LakeMaps/Dartmouth/README.md

# PCB
This is where the PCBs go, because "boat" was taken
