LakeMaps/Dartmouth/Settle/settle.kicad_pcb

## KiCad design Settle/settle.kicad_pcb (2016-10-25)

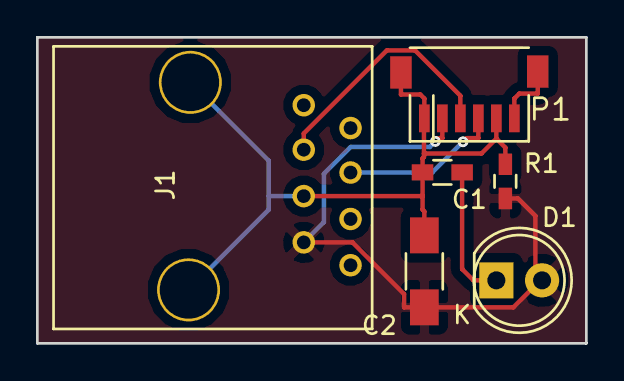
[picture p1: board settle.kicad_pcb from above]

Board: 2 copper layers, 30.5 x 17.0 mm, 6 parts (0 on the bottom side), 5 nets.

Parts:
C1: 0.1u; C_0603_HandSoldering
C2: 10u; C_1206_HandSoldering
D1: LED; LED-5MM
J1: RJ45; RJ45_Header
P1: CONN_01X06; JST-6
R1: 150; R_0603_HandSoldering

Connections:
+5V: C1.1, C2.1, D1.2, J1.2, P1.2
/Rx: J1.6, P1.3
/Tx: J1.5, P1.4
Earth: C1.2, C2.2, J1.4, J1.9, P1.1, P1.5, R1.2
unnamed: D1.1, R1.1
