LakeMaps/Dartmouth/Cranberry/cranberry.kicad_pcb

## KiCad design Cranberry/cranberry.kicad_pcb (2016-10-25)

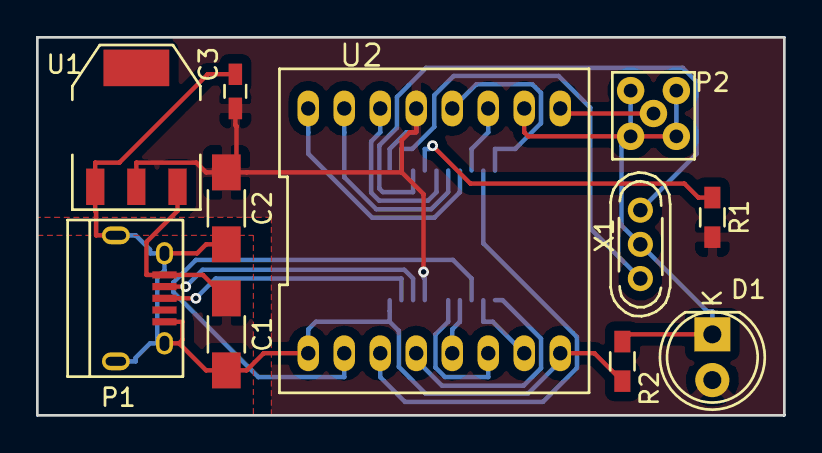
[picture p2: board cranberry.kicad_pcb from above]

Board: 2 copper layers, 41.5 x 21.0 mm, 12 parts (1 on the bottom side), 21 nets.

Parts:
C1, C2: 4.7u; C_1206_HandSoldering
C3: 10n; C_0603_HandSoldering
D1: LED; LED-5MM
P1: USB_OTG; USB_Micro-B
P2: SMA; RP-SMA
R1: 390; R_0603_HandSoldering
R2: 33; R_0603_HandSoldering
U1: NCP1117ST33T3G; SOT-223
U2: RFM69HCW; RFM_Module
U3: MCP2210; SSOP-20_5.3x7.2mm_Pitch0.65mm
X1: 12MHz; Crystal_HC52-U_Vertical_3Pin

Connections:
+3V3: C2.1, C3.1, D1.2, R1.1, U1.2, U2.13, U3.1, U3.17
+5V: C1.1, P1.1, U1.3
/IO0: U2.14, U3.5
/IO1: U2.15, U3.6
/IO2: U2.16, U3.7
/IO3: U2.11, U3.8
/IO4: U2.12, U3.10
/IO5: U2.7, U3.12
/MISO: U2.2, U3.13
/MOSI: U2.3, U3.9
/RFM_RST: U2.6, U3.15
/SCK: U2.4, U3.11
/SS_0: U2.5, U3.14
/USB_D+: P1.3, U3.19
/USB_D-: P1.2, U3.18
Earth: C1.2, C2.2, C3.2, P1.5, P1.6, P2.2, R2.2, U1.1, U2.1, U2.8, U2.10, U3.20, X1.3
unnamed: D1.1, R2.1
unnamed: P2.1, U2.9
unnamed: R1.2, U3.4
unnamed: U3.2, X1.1
unnamed: U3.3, X1.2
