LakeMaps/Dartmouth/Loon/loon.kicad_pcb

## KiCad design Loon/loon.kicad_pcb (2016-10-25)

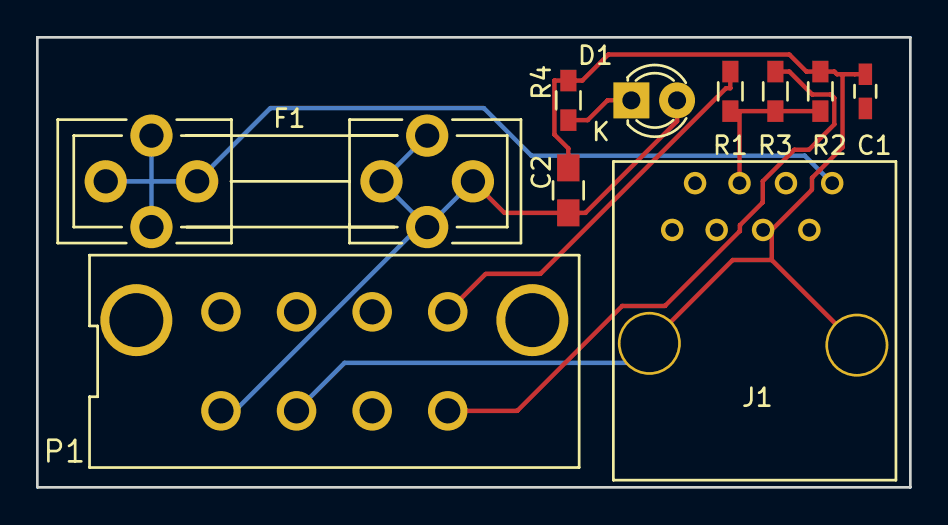
[picture p3: board loon.kicad_pcb from above]

Board: 2 copper layers, 48.5 x 25.0 mm, 10 parts (0 on the bottom side), 7 nets.

Parts:
C1: 0.1u; C_0603_HandSoldering
C2: 10u; C_0805_HandSoldering
D1: LED; LED-3MM
F1: FUSE; Fuseholder5x20_horiz_open_universal_Type-III
J1: RJ45; RJ45_Header
P1: CONN_01X07; 8_Pin_Minifit
R1, R2, R3: R; R_0603_HandSoldering
R4: 1k; R_0603_HandSoldering

Connections:
+12V: F1.2, J1.1
/12_fuse: C2.1, D1.2, F1.1, P1.1
/Tx: J1.5, R1.1, R2.2, R3.1
Earth: C1.2, C2.2, J1.4, J1.9, P1.2, R3.2, R4.2
unnamed: D1.1, R4.1
unnamed: P1.4, R2.1
unnamed: P1.5, R1.2
