LakeMaps/Dartmouth/Dartmouth/dartmouth.kicad_pcb

## KiCad design Dartmouth/dartmouth.kicad_pcb (2016-10-25)

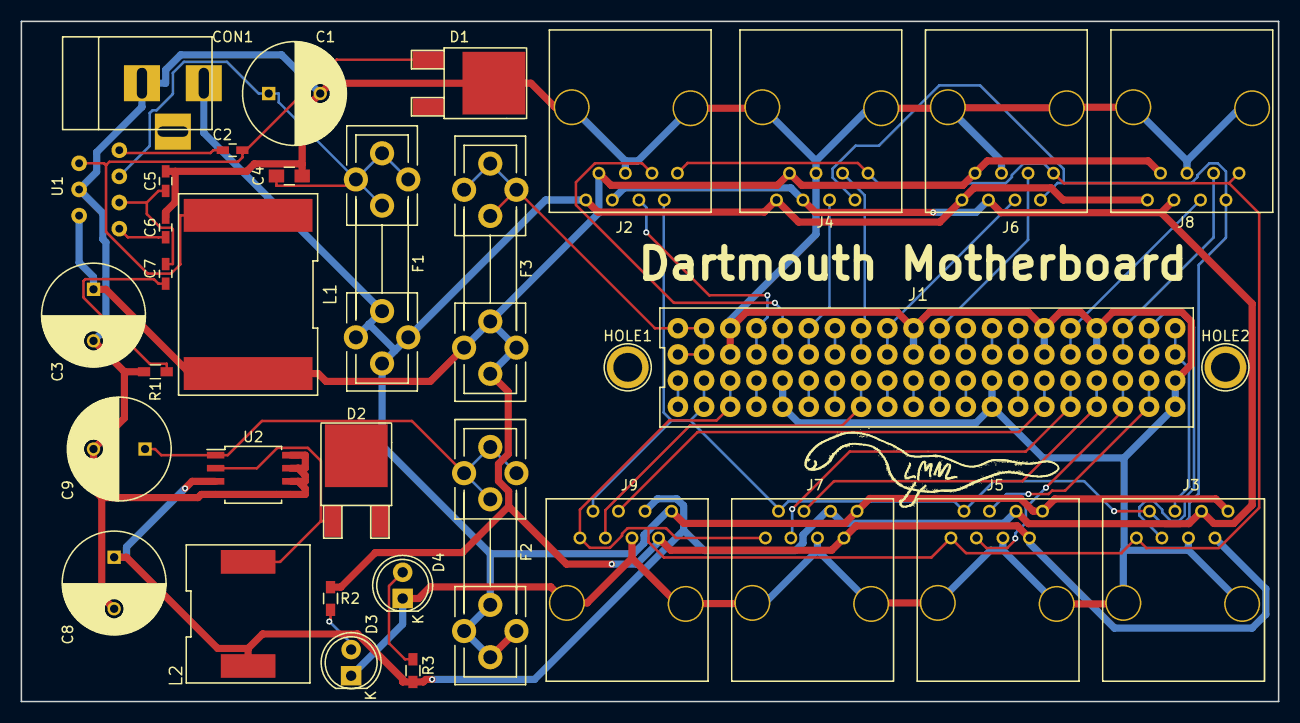
[picture p4: board dartmouth.kicad_pcb from above]

Board: 2 copper layers, 122.0 x 66.0 mm, 36 parts (0 on the bottom side), 33 nets.

Parts:
C1: 2200uF; C_Radial_D10_L13_P5
C2, C6: 0.22uF; C_0603_HandSoldering
C3: 470uF; C_Radial_D10_L13_P5
C4: 4.7uF; C_0805_HandSoldering
C5: 680pF; C_0603_HandSoldering
C7: 1200pF; C_0603_HandSoldering
C8, C9: 470u; C_Radial_D10_L13_P5
CON1: BARREL_JACK
D1, D2: STPS1045B-TR; TO-252-2Lead
D3, D4: LED; LED-5MM
F1, F2, F3: FUSE; Fuseholder5x20_horiz_open_universal_Type-III
HOLE1, HOLE2: 1pin
J1: RPi_GPIO; Raspi_Header
J2, J3, J4, J5, J6, J7, J8, J9: RJ45; RJ45_Header
L1: 56uH; SRP_Series_Ind
L2: 47uH; SRR1210A_Series_Ind
LOGO: GrandyHype_25mm
R1: 39k; R_0603_HandSoldering
R2: 220; R_0603_HandSoldering
R3: 33; R_0603_HandSoldering
U1: SI-8050Y; TO-220-7
U2: AP1509; SOIJ-8_5.3x5.3mm_Pitch1.27mm

Connections:
+3V3: C8.1, J2.3, J3.3, J4.3, J5.3, J6.3, J7.3, J8.3, J9.3, L2.1, R3.1, U2.3
+5V: C3.1, F3.1, J2.2, J3.2, J4.2, J5.2, J6.2, J7.2, J8.2, J9.2, L1.2, R2.1, U1.6
+12V: CON1.1, F1.1, F2.1, J2.1, J3.1, J4.1, J5.1, J6.1, J7.1, J8.1, J9.1
/5VPi: F3.2, J1.2, J1.4
/12-3v3Fused: C9.1, F2.2, U2.1
/12-5Fuse: C1.1, C4.1, F1.2, U1.3
/GPIO05: J1.29, J9.5
/GPIO06: J1.31, J7.6
/GPIO12: J1.32, J8.5
/GPIO13: J1.33, J7.5
/GPIO14: J1.8, J2.5
/GPIO15: J1.10, J2.6
/GPIO16: J1.36, J8.6
/GPIO18: J1.12, J4.5
/GPIO19: J1.35, J5.6
/GPIO20: J1.38, J3.6
/GPIO21: J1.40, J3.5
/GPIO22: J1.15, J9.6
/GPIO23: J1.16, J4.6
/GPIO24: J1.18, J6.5
/GPIO25: J1.22, J6.6
/GPIO26: J1.37, J5.5
/SCL: J1.5, J2.8, J3.8, J4.8, J5.8, J6.8, J7.8, J8.8, J9.8
/SDA: J1.3, J2.7, J3.7, J4.7, J5.7, J6.7, J7.7, J8.7, J9.7
Earth: C1.2, C3.2, C4.2, C5.2, C6.2, C8.2, C9.2, CON1.2, D1.2, D3.1, D4.1, J1.6, J1.9, J1.20, J1.25, J1.30, J1.34, J1.39, J2.4, J2.9, J3.4, J3.9, J4.4, J4.9, J5.4, J5.9, J6.4, J6.9, J7.4, J7.9, J8.4, J8.9, J9.4, J9.9, R1.2, U1.4, U2.4, U2.5, U2.6, U2.7, U2.8
unnamed: C2.1, U1.1
unnamed: C2.2, D1.1, L1.1, U1.2
unnamed: C5.1, C7.1, U1.5
unnamed: C6.1, U1.7
unnamed: C7.2, R1.1
unnamed: D2.1, L2.2, U2.2
unnamed: D3.2, R2.2
unnamed: D4.2, R3.2
