LakeMaps/Dartmouth/(threads)

Thread 1 (2016-07-27):

Motherboard Design

FifoIronton, 2016-07-27:
We need to map out what we want on this board.
This board is pretty much a header for the Raspberry Pi.
Needs:
- Power rails,
- 12V to 3V, 12V to 5V buck convertors
- Standard mother to daughter 8 pin JST terminals ( 2 GPIO, 3.3V, 5V, GND, SDA&SCL, something else)
- USB Bus?
- Logo

We should use this issue to develop a discussion of the components.

arandell93, 2016-07-27:
I don't think we need a USB bus. We can't get a USB bus off of the headers on the Pi anyway.

We need to have no connects to all of the Pi's voltage outputs, since we're going to be bringing in our own power from our DC/DC converters to all the devices. However, all of the grounds will be common (unless there is a reason not to, but I can't imagine having a noisy ground in this system).

For the pins that aren't scheduled to be used for daughterboard connections, we should break them out onto similar connectors anyway in case we want to use them. For example, the SPI bus on the Pi could be brought out to an 8pin JST with 5V, 3.3V, GND and a couple no connects.

arandell93, 2016-07-27:
Not sure if JST is the best to use, I think putting the pins in is difficult.
What are your thoughts on using something like CAT5/RJ45? They're easy to use, the crimp tools are cheap and I have 185 feet of cable already.
I know it's kinda gross because we'd be using a standardized port for something non-standard, but there are a good few pros.
Thoughts?

FifoIronton, 2016-07-27:
I'll be honest, I just kind of assumed that this connector was JST : http://www.digikey.com/product-search/en?mpart=71600-108LF&vendor=609 . These interface with 10mil pin headers, which are nice.

Turns out I was wrong. If you have CAT5 cable and the skills to terminate, although it hurts me I can do it, because cheap solutions sound like a good idea

arandell93, 2016-07-27:
I haven't seen those before haha. JST is super small.
It hurts me too but I think it's a good decision in terms of ease of manufacture and costs. RJ45 it is!

arandell93, 2016-08-11:
Preliminary _in progress_ design
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

arandell93, 2016-08-11:
Markup as submitted to @FifoIronton on 2016-08-10 22:45
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

Closed 2016-11-06.

Thread 2 (2016-07-27):

'Cranberry' Radio Module Daughterboard

FifoIronton, 2016-07-27:
Need to create a radio module breakout board for RFM9XW. We want:
- RPSMA output
- SPI to microUSB port
- 3.3V linear regulator

arandell93, 2016-07-27:
Since we need two modules (one on the boat and one on shore), I think we're best making them identical.

Note: We are going to be bringing ONLY a USB cable to these modules. Power will be in the form of 5V via USB, so a USB hub is required to provide enough current.

Any SPI to USB converter chip we get will have to be capable of at least 300 kbit/s

arandell93, 2016-07-27:
I'm gonna go ahead and make this priority ahead of the motherboard, as I feel this will take the most work to get sorted (config, testing, antenna messing), and it is independent of the motherboard so the latter work can be parallel to the development of the other boards.

arandell93, 2016-07-27:
Potential SPI to USB converter:
https://www.digikey.ca/product-detail/en/microchip-technology/MCP2210-I-SS/MCP2210-I-SS-ND/2835087
Also available in SMD, but I think this package would be easier to solder to.

FifoIronton, 2016-07-27:
We wouldn't be able to use the alternate package that they have, as the pads are underneath the chip on that package.

Speaking of that, we should probably aim to get several of the boards done so I can solder and verify them at Solace - the pins on the chip you've shared are only separated by about a millimeter, and Solace much smaller soldering irons than I have access to at MUN.
I'm not sure if Solace'll let me borrow a key for after hours access during the semester, but I will ask about it closer to the end of my work term.

arandell93, 2016-07-27:
Yeah that's what I'm thinking. I'll create a tracking issue for that.

FifoIronton, 2016-08-01:
First draft of schematic fleshed out as of 87f1c00

If you think this looks appropriate I will continue working towards finishing layout ASAP
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

arandell93, 2016-08-01:
Are we using any of the IO on the radio module? I see you've got them all connected to the USB-SPI bridge GPIO, but do we know how to get at the GPIO in software via the USB interface?

FifoIronton, 2016-08-01:
I'll be honest, I haven't actually read the full data sheets for both of them. I'm like 80% sure that the GPIO are controlled by the USB interface, as they'd be needed as for Slave Select (SS) pins for the SPI interface (assuming you're not doing some complex Daisy Chaining thing).
Based on the LoRa balloon system I've shown you before, the guy connects some of the IOs on that module for selecting options or something in his [software](https://github.com/daveake/LoRaArduinoSerial/blob/master/LoRaArduinoSerial.ino). It's another thing I haven't actually read, but I want to figure out what's going on there

FifoIronton, 2016-08-07:
Next time let's get the SOIC footprint instead of the SSOP footprint. Wider lead spacing, which is good for me

FifoIronton, 2016-08-17:
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
Things to be done:
- Change hole sizes
- Put a fun label on?
- make sure it doesn't suck

arandell93, 2016-08-17:
- Am I correct in understanding that the MCP2210 is underneath the RFM69HCW where the MCP is surface mount on one side and the RFM is through-hole mounted on the other?
 - Side note: We will need pins (what spacing) to mount the RFM through-hole.
- Power LED resistor should be 33 Ohms.

FifoIronton, 2016-10-25:
Rev1 Schematic of this board
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

Closed 2016-11-06.

Thread 3 (2016-07-27):

Choose kooky naming scheme for boards

FifoIronton, 2016-07-27:
When I worked at a big company, families of boards that they designed all had internal names based on a   set theme. For example, in one family, all cards were named after stars, and in another family all of the cards were named after characters from a movie.

I think we should emulate this on our project, mostly so that everything sounds a little sillier when we talk about it. Also, I'm jealous that the control software repository gets to be called "boat", while I have a repository called "PCB" currently.

Some options for a board naming theme:
- YuGiOh Cards in a 2011 era Frog deck, or maybe an Elemental Hero Absolute Zero Deck
- Names of lakes geographically close to my family home in Dartmouth
- Different names of blue Crayola crayons, with the motherboard being named "Blue"
- My favourite flavours of herbal tea

What do you guys think?

arandell93, 2016-07-27:
I like the names of ponds & puddles close to your family home in Dartmouth.
We can call the motherboard Dartmouth then?

I also like the blue crayola crayon idea.

FifoIronton, 2016-07-27:
Dartmouth it is then, I'll implement the changes when I get back home

arandell93, 2016-07-27:
Close the issue once you've implemented the naming scheme.

Closed 2016-07-27.

Thread 4 (2016-07-27):

Tracking: PCB Board Design & Fabrication

arandell93, 2016-07-27:
These are listed in order of priority.
Each board should have a separate issue created for it to discuss relevant things, but progress will be tracked here and dates will be assigned.
### Radio Module Board (#2)
- [ ] Circuit Design & Schematic [August 3]
- [ ] Component Selection [July 28]
- [ ] PCB Layout [August 3]
- [ ] PCB Ordering [August 5]
- [ ] PCB Assembly
- [ ] Testing
### Motherboard (Dartmouth) (#1)
- [ ] Circuit Design & Schematic [August 3]
- [ ] Component Selection [August 3]
- [ ] PCB Layout
- [ ] PCB Ordering
- [ ] PCB Assembly
- [ ] Testing
### GPS Daughterboard
- [ ] Circuit Design & Schematic
- [ ] Component Selection
- [ ] PCB Layout
- [ ] PCB Ordering
- [ ] PCB Assembly
- [ ] Testing
### Sonar Daughterboard
- [ ] Circuit Design & Schematic
- [ ] Component Selection
- [ ] PCB Layout
- [ ] PCB Ordering
- [ ] PCB Assembly
- [ ] Testing
### Motor Controller Daughterboard
- [ ] Circuit Design & Schematic
- [ ] Component Selection
- [ ] PCB Layout
- [ ] PCB Ordering
- [ ] PCB Assembly
- [ ] Testing

Closed 2016-11-06.

Thread 5 (2016-08-03):

Dartmouth Daughterboard Interface

arandell93, 2016-08-03:
The plan is to use a USB Hub and multiple USB to UART converters in order to achieve the required number of serial ports.
We require the following hardware for this implementation:
- USB-A to USB Micro-B cable
- USB Micro-B port
- USB Hub IC ([TUSB2036](http://www.ti.com/product/tusb2036), [USB2502](http://ww1.microchip.com/downloads/en/DeviceDoc/2502.pdf) or similar)
- External Oscillator for above (depending on IC selection)
- USB to UART IC (Preferably multiple in one IC like the quad [FT4232H](http://www.ftdichip.com/Support/Documents/DataSheets/ICs/DS_FT4232H.pdf))

@FifoIronton have a quick google and let me know what you think. The USB Hub ICs are a lot of pins, so soldering could get quite difficult.
It's also very important that we completely understand the interfacing requirements prior to purchasing. For example, it looks like the [FT4232H](http://www.ftdichip.com/Support/Documents/DataSheets/ICs/DS_FT4232H.pdf) has other connections besides USB, and we don't want things to get complicated.
We always have the 'dumb' alternative of buying a USB hub and connecting several USB cables with single USB-Serial converters on it.

FifoIronton, 2016-08-17:
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
Dump of Dartmouth Images

FifoIronton, 2016-08-17:
Still to do
- Put some lettering in front copper layer on board
- Change all drill holes to holes APC will do for free
- Make sure it doesn't suck

arandell93, 2016-08-17:
- 150 Ohm resistor is not appropriate for 5V and 3.3V LED. 3.3V resistor should be lower. I assume we're using 10mA LEDs with a 3V drop so the correct values are 200 (210 standard) for 5V and 30 (33 standard). Doesn't affect the board itself but note the change in the next board revision.
- There isn't a requirement to bring 3.3V from our DC/DC converter to the Pi's GPIO because the Pi generates its own 3.3 V. The fuse in this location is also consequently not needed.
- The intention of the fuses on the board is to protect the line (12 V) side of the dc/dc converters individually from short circuiting, as well as one on the input to the Pi to make up for us bypassing it and going to the GPIO. The line side fuses do not currently exist.
 - If it would be easier, we can use the existing 3.3V fuse as the load side of the 3.3V dc/dc converter and have all 3.3V loads running through it (except the unnecessary Pi connection as noted above).
 - We will still need to add a fuse for the 5V as well. If we do load side for the 3.3V we can do load side for the 5V (aside from the Pi which still needs a dedicated fuse). However, my preference would be to re-purpose the existing 3.3V pi fuse into a fuse protecting the line (12V) of the 3.3V and to add another fuse on the line (12V) side of the 5V converter.
 - Both options require the addition of one fuse to the board for a total of 3.

Closed 2016-11-06.

Thread 6 (2016-08-04):

Create logo and decide on vendor for PCB manufacturing

FifoIronton, 2016-08-04:
Somebody's gotta create a Black/White logo for me to put on the silkscreen of the boards. You know it will look way cooler if we do that (assuming we're getting the solder mask and silkscreen on our boards).

If nobody else does it, I'm going to make something stupid, so be warned

arandell93, 2016-08-04:
Yeah I agree we need a logo haha. I've been looking at some lakes with a mountain background kinda things but I'm awful at making creative things.

What are you thinking for a vendor?

FifoIronton, 2016-08-04:
I spent a bit of time looking today, and for our order quantities we're kinda out of luck for getting a cheap product with low lead time. We could, if we commit to single layer boards with only surface mount components, we can [etch our own boards](http://makezine.com/projects/cheap-friendly-and-precise-pcb-etching/), which means that we have to jump through a bunch of design hoops and spend time making them, but we end up saving a fair bit of money for a product similar to what we'd get from APC.

If we decide against that, it appears that for extremely low numbers of boards APC is a good company to work with. Otherwise, we can go through China with a company like [this one ](https://www.seeedstudio.com/fusion_pcb.html)my friend recommended, even though they require a minimum of 5 boards (that being said, if you want tiny boards they'll be like $2USD each + shipping).

You can also look at this [list here](http://digitaldiy.io/general-electronics/321-pcb-fabrication-sources.html#.V6ONqbuAOko) that walks through a bunch of places (mostly for US customers) and outlines their prices

cgregory52, 2016-08-04:
I know very little about potential issues with PCB printing so take my opinion with a grain of salt. Anything handmade has a high likelihood of failure so count on double to tripled costs for when the part inevitably breaks and we need a new one. In my mind, the small cost savings per board are a negligible bonus here so the decision should be made based on which design is better/easier. If we're jumping through design hoops, potentially creating a lower quality product on our own with a high rate of failure I do not see this as being worthwhile. Printed boards remove a large number of potential failure points from debug considerations as well. We wouldn't necessarily need to look at every PCB solder joint as a point of failure each time something stops working. Time and money are both resources and for the potential time savings alone, I think the additional monetary cost is justified.

FifoIronton, 2016-08-04:
With that in mind, I will proceed with my layouts using 2 layer boards, because they are much easier to design than single layer boards. I just wanted to present the most cost effective option, while also showing the alternatives.

The next question is just how much we're willing to spend on PCBs and how important it is to us that they're done quickly. APC is definitely the most convenient option because we've worked with them before, they're based in Canada, and they have really low lead times, but for the batches we're doing they're pretty pricey. If we go through China it's hard to get small batches, but we can get big batches for cheaper than APC will give us the small batches, but we gotta wait.

arandell93, 2016-08-05:
I'm definitely in favour of getting them done by someone.
I think if we can get our quantities high enough we should go with one of the cheaper Chinese options provided the lead times aren't insane.

Closed 2016-11-06.

Thread 7 (2016-08-08):

GPS PCB Design

arandell93, 2016-08-08:
The PCB for the GPS needs the following:
- 6 pin connector for the GPS module
- 5 V Power
- 5 V TTL UART (TX and RX)
- Associated passive components (Caps, etc)
- Power LED

The GPS module is an [EM 406](https://www.sparkfun.com/datasheets/GPS/EM-406%20Product_Guide1.pdf).

arandell93, 2016-08-11:
Initial Design:
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

arandell93, 2016-08-11:
### Requires
- Ethernet Port Shield (9) should be grounded.

FifoIronton, 2016-08-17:
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
To Do:
-Change hole diameters to the free holes from APC
-Make the layout eaier to read, even though there won't be any silk screen
-Make sure it doesn't suck

arandell93, 2016-08-17:
- LED resistor should be 210 ohms.
- Confirm GPS port is correct type (JST SH Vertical [or Horizontal] 6-Pin)

Closed 2016-11-06.

Thread 8 (2016-08-08):

Sonar PCB Design

arandell93, 2016-08-08:
The PCB to integrate with the Sonar unit requires the following:
- 12 V
- RS-422 to TTL converter (Such as [3179E](http://www.intersil.com/content/dam/Intersil/documents/isl3/isl3179e-80e.pdf) or [7306](http://www.analog.com/media/en/technical-documentation/data-sheets/AD7306.pdf)). These will convert the 422 from the NMEA 0183 sentences the sonar outputs to TTL for interpretation by our controller.
- Caps as required
- A 7 pin connector (Need to know wire size on transducer cable in order to size connector type)
- In-line fuse on 12 V input (2A)

Note: No connection on the ACC ON pin.
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

FifoIronton, 2016-08-09:
According to this [TI application note](http://www.ti.com/lit/an/snla041a/snla041a.pdf), there is no need for a converter, as RS-422 can drive a TTL receiver. Look at page 5.

arandell93, 2016-08-09:
Interesting...
Seems legit though. As long as the TTL input on the chip we select for our UART can tolerate the voltage levels we should be good to go! I'd say anything that's 13 V tolerant on the input would be good.
Let's allocate for a voltage divider on the RX of the UART chip to drop the voltage to something safer just in case the TTL isn't tolerant of the voltages. If we don't need it we can jump it.

arandell93, 2016-08-11:
Preliminary _in progress_ design
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

arandell93, 2016-08-11:
Initial Design:
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

arandell93, 2016-08-11:
### Requires
- Power LED (From 12 V)
- 2A Inline Fuse (20x5mm horizontal fuse holder)

FifoIronton, 2016-08-17:
We still haven't decided on a termination for the sonar wire. Not sure what to do, but layout will be easy once we decide. @arandell93 or @michaelabarnes , you guys know sonars, what is the standard termination? If I don't get a response by Wednesday night I'll assume something simple with 10mil spacing

arandell93, 2016-08-17:
The intelliducer comes with non-terminated ends. Let's do something simple and easy to repair/replace. I'm tempted to do something dumb like ring terminals. You often see an XLR looking connector but that's complicated and expensive.
If I knew how big the wires were I'd pick a c-grid and be done with it, but I'm concerned that the wires are going to be like 18 gauge and then we'd be out of luck as far as a c-grid goes. We could use minifit connectors (There are some at EER that will never again be used because I hid them all away and they're only rated for 6A and are really big). They'd work well enough for us.
Thoughts?

FifoIronton, 2016-08-17:
From looking "Minifit connector" up on google, it looks like they still require you to put crimp connectors on the wires, are they bigger crimps than in C-Grids?

arandell93, 2016-08-17:
Yeah the minifit will take up to a 16 I think, depending on the crimp pins you buy. Definitely big enough for our purposes. You can also get right-angle and vertical through-hole connectors, in fact we may have some available to us. Worth looking at the shop.

Closed 2016-11-06.

Thread 9 (2016-10-05):

PCB probs

FifoIronton, 2016-10-05:
-RP Sma antenna holder wrong size
-Fuse holder a little small
-Inductors are too big
-power planes not poured on Dartmouth
-header pins ordered improperly
-3mm led should be a 5

Thread 11 (2016-11-06):

Options for Radio Communication

FifoIronton, 2016-11-06:
Relooking at how to attach the RFM69HCW Boards to our system means we need to evaluate different options. I'm going to present all the options I can see, with comments on how much I like them. The major issue we've faced with the RFM Modules is that they have 3.3V logic levels, and we're trying to throw 5V into them, which is bad.

* Buy [RFM Module](http://www.digikey.ca/product-search/en?mpart=COM-13909&vendor=1568), solder some resistor dividers onto a protoboard for the level shifting, and also solder jumpers from the module to the protoboard. Add some headers, connect to the Arduino Unos we have, and we should be good.
This idea is the cheapest option, and has a high chance of working with very minimal changes to our system. The only issue that we may run into is the stray capacitance of the resistors, which could mess with the SPI signals... Doubt it, but it's a possibility. As we are using physical components to step down the voltages, we are limited in how we use the IOs with this, but I doubt we'll really use those on the radio. For the sake of a few extra cents, we could also try using [through-hole level shifters](http://www.digikey.ca/product-detail/en/texas-instruments/CD4504BE/296-3527-5-ND/376626) to save space and make it look a little nicer
  * Materials: 2x [RFM69HCW Modules](http://www.digikey.ca/product-search/en?mpart=COM-13909&vendor=1568) ($7.14 each), protoboards, resistors, etc, from MUN.
  * Cost: $14.28 + Tax, Shipping

* Buy a [radio breakout board with level shifters built in](http://www.digikey.ca/product-detail/en/adafruit-industries-llc/3070/1528-1665-ND/6005355). Although a little more expensive, this solution has a couple of benefits over the previous option. We can easily insert this breakout board into a breadboard for prototyping, as we can solder 100mil headers onto this board, and it runs directly off of 5V logic without the need for our own resistor divider circuits.
  * Materials: 2x [Adafruit 3070 breakout boards](http://www.digikey.ca/product-detail/en/adafruit-industries-llc/3070/1528-1665-ND/6005355) ($14.36 each), breadboard, 100mil headers ([10 pos](http://www.digikey.ca/product-detail/en/sullins-connector-solutions/PREC009SAAN-RC/S1012EC-09-ND/2774845) and [5 pos](http://www.digikey.ca/product-detail/en/harwin-inc/M20-9990546/952-2268-ND/3728232))
  * Cost: $29.72 + tax, Shipping

* Buy our own 3.3V [Arduino Pro Micro boards](http://www.digikey.ca/product-search/en?mpart=DEV-12587&vendor=1568), hook them up to RFM69HCW modules. Pretty simple, but more expensive than buying the breakout boards with 3.3V built in... but then we own 3.3V microcontrollers, freeing up our Unos for other tasks and allowing us to upgrade to the LORA boards in the future without having to pay for level shifting boards again. I like this option, as it is more compact than using an UNO, but am a little hesitant based on the price. There are other cheaper options involving Arduino Pro Mini boards, and the magic of a USB to serial converter, we we can use to bring the cost down, if this sounds like a good option.
  * Materials: 2x [RFM69HCW Modules](http://www.digikey.ca/product-search/en?mpart=COM-13909&vendor=1568) ($7.14 each), 2x [Arduino Pro Micros](http://www.digikey.ca/product-search/en?mpart=DEV-12587&vendor=1568) ($29.79 each)
  * Cost: $73.86 + Taxes, shipping
* Buy Adafruit's [RFM69HCW Feather Board](http://www.digikey.ca/product-detail/en/adafruit-industries-llc/3076/1528-1663-ND/5983112). These are as expensive as the previous solution, but also idiotproof. They've got everything built into one package, so you know that you're getting what you're looking for; however, if we want to switch radios in the future then we have to pay for all the extra microcontroller stuff again.
  * Materials: 2x [RFM69HCW Feather Boards](http://www.digikey.ca/product-detail/en/adafruit-industries-llc/3076/1528-1663-ND/5983112) ($36.01 each)
  * Cost: $72.02 + Taxes, shipping

Thoughts?

arandell93, 2016-11-06:
A few comments:

- You left out the RFM69HCW modules in the breakout board option. Do they come preinstalled?
- I like that the breakout board has the ability to solder on an SMA connector directly. While we could do it with our own protoboard it would be a bit messy. Using the feather would require us to use a uFL connector and then an adapter to SMA which I'm not a fan of.

I like the breakout board option since it gives us easy prototyping ability and is still relatively low cost.

FifoIronton, 2016-11-06:
I'm 95% sure that the breakout boards come with the radio modules pre-installed, based on the [description given on Adafruit](https://www.adafruit.com/product/3070), the manufacturer. Sounds like a good solution for now, we should put in an order after figuring out if there's anything else from Digikey we should get.

arandell93, 2016-11-06:
Yeah it appears they do have the boards on them.
What else might we need?

FifoIronton, 2016-11-07:
I guess it depends on if we want to pick up antennas. It's pretty early for that now, but we could pick them up. Other than that, all I see us needing are the boards, along with some headers. I have two breadboards, but if you wanted [more](http://www.digikey.ca/product-detail/en/bud-industries/BB-32621/377-2094-ND/4156445) we could order them. I don't recommend it, as there's no time crunch and they're [cheaper out of china](https://www.amazon.ca/COLEMETER-Solderless-Breadboard-Points-Contacts/dp/B00CGVFPRY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).
... Beyond that, I can't really think of anything.

arandell93, 2016-11-07:
I agree we don't need to buy an antenna or breadboards.
The boards come with headers, don't they?

FifoIronton, 2016-11-07:
I think so, but it only mentions it on the Adafruit page, not on Digikey, and headers for the each of the boards are 50¢, so I think we're better off splurging.

arandell93, 2016-11-07:
Good point. We'll order a few. We'll probably need some at some point for other things anyway.

arandell93, 2016-11-08:
I'm going to place the order for the following today. Confirm that it looks good to you. please @FifoIronton.

QTY 2:
[RFM69HCW Breakout Board from Adafruit](http://www.digikey.ca/scripts/DkSearch/dksus.dll?Detail&itemSeq=211263501&uq=636141826849499853)

QTY 2:
[40 Position, 0.1" Male Breakway Headers](http://www.digikey.ca/scripts/DkSearch/dksus.dll?Detail&itemSeq=211263745&uq=636141828558100696)

FifoIronton, 2016-11-08:
The links you provided in your comment don't work for me, but sounds good to me, regardless.

FifoIronton, 2016-11-08:
I can't quite figure out which issue I should mention this on, so I'll also mention it here - we need another Arduino if we're going to have a separate Hangashore comms Arduino, Pudding comms Arduino, and Pudding motor control Arduino. We can buy a [legit one](http://www.digikey.ca/product-detail/en/arduino/A000066/1050-1024-ND/2784006) from Digikey for >$30, or we can be bad people and buy a cheap clone (something like [this](https://www.amazon.ca/LANDZO-Arduino-Atmega328-Maker-Learner/dp/B01IGQ38DU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)), understanding that there will be a little more lead time.

arandell93, 2016-11-08:
Good point. I've got a spare arduino somewhere at my house, but I'm not sure whether it's an uno or a micro. It's from my senior design project. I'd prefer not to buy anything further for Rev 1 so we'll make due with that, or borrow one of EER's Megas or something.

Closed 2017-03-07.

Thread 12 (2017-03-06):

Standardization of Electronics

arandell93, 2017-03-06:
I am in the process of reviewing our current approach to hardware design and believe that it is in our best interest to begin standardizing certain aspects of our system. This includes things like components, colours, and other design motifs.

I've added a folder to the Google Drive called design resources which we can use to hold appropriate best practices and standards. We should use these where possible to justify our decisions.

This issue is to facilitate the discussion of the standardization in terms of modifications to existing systems and to (as much as possible) avoid issues in the future with the required hardware outlined in the development milestones.

arandell93, 2017-03-07:
Some talking points. @FifoIronton @whymarrh @cgregory52 looking for all of your input and priorities.

## Wire Colour
Wire colouring serves as a method by which a designer communicates the function of a circuit quickly and unambiguously. This is used to increase safety and decrease troubleshooting time. There are various other lesser considerations we may come across and want to apply, but we optimize for the two aforementioned goals.

To what level of specificity do we want to assign wire colours to meanings? Generally, there are several schools of thought in assigning wire colours:

- Voltage-based. This is generally the minimum and is used as a form of safety indication. By looking at a wire you know what voltage would exist if it were energized and you can determine whether or not you should be working on a circuit while it is live. This is common in mixed AC/DC power systems.
- High-Level function. As a step up from voltage-based, you would colour wires that are used for signalling differently than those used for power distribution. This differentiates between power distribution, communications, and input/output. This is common in industrial control applications.
- Low-Level Function. Here, you would employ a large variety of both solid and striped colours in order to assign wires on a nearly one-to-one function basis. This is common in the automotive industry.

Currently on the boat, we have the following functions (at the lowest level):

- +12 VDC
- +5 VDC
- Common (0 VDC, ungrounded)
- PWM controlled motor power (+/- 0-12 VDC)
- UART TX at various baud rates (microcontrollers use 115200, motor driver uses 9600 but we can [change this](https://www.pololu.com/docs/0J29/4.b), GPS uses 4800 but we can change this (lakemaps/boat#40).
- UART RX at various baud rates
- Reset Signal to motor driver
- Error Signal from motor driver
- Reset Signal to wireless module
- SPI (4 wire; CLK, CS, MOSI, MISO) to/from wireless module
- Interrupt from wireless module

## Wire Size

## Wire Routing/Grouping and Component Layout

## Termination Types

## Microcontroller Type

FifoIronton, 2017-03-07:
My opinions on wire colour are to make as many distinctions between signals as is practical. On a previous project that we all worked on, we used as many colours as we could (each DC voltage had a colour, each class of signals had a colour, lines that were easy to confuse like tooling motor voltages were different colours), and it made the mess of wires inside of the robot bearable.

I do not think that we can separate every single function into a different colour line, but if we made the default digital signal colour grey (or whatever we can get cheap), and differentiated signals from there, I think that we could make the system easier to work with

arandell93, 2017-03-07:
I tend to agree, as I knew the guy who came up with the colours for that project and generally think he knew what he was at. However, I feel there were flaws in that system and would like to resolve them here. I feel it was not explicit enough and was over-constrained in some cases, particularly when it came to edge cases (control PWM, tooling motor power).

I'll propose the following classifications for wires. We can add colours later. Input welcome.

- 12 VDC (I propose this include the switched power to motors or similar devices)
- 5 VDC
- 3.3 VDC (Not currently used, but may be worth reserving unless we decide to standardize on 5V and work around requiring transport of 3.3 V via wire)
- Common/Ref
- Asynchronous Serial
- Synchronous Serial
- Digital (including PWM and other switching control signals)
- Analog (Not currently used)

arandell93, 2017-03-07:
##Wire Specs

For wire specs, I think it would be worth standardizing all non-current-carrying (control) conductors to a single type of wire. This would not only include gauge but insulation type and strand count/size. Similarly, we would apply this insulation type and strand size to the power wiring, though it would have a different number of strands and would obviously be larger gauge. We must be able to easily source this wire from somewhere like digikey or newark.

For control conductors, I propose the following:

- #24 AWG
- Type TEW, 600 V, CSA

To be continued

arandell93, 2017-03-08:
Gonna go ahead and say we're gonna have TX and RX be different colours for debugging purposes. I'll edit my comment above.

FifoIronton, 2017-03-08:
@ Wire Spec - I've been asleep for quite a while but... are we using stranded wires for our digital signals? For prototyping, solid core wire generally works much better with breadboards and arduinos and all that, but in my slumber I've really been missing out on what the system looks like at this point

arandell93, 2017-03-08:
> are we using stranded wires for our digital signals
Stranded for everything. Solid is not suitable for much other than prototyping. We will put header pins on all female headers so we can connect using appropriate wiring with terminations.
