LakeMaps/Dartmouth/(commit log)

2016-07-27 Initial commit of project files
    [motherBoard.kicad_pcb, motherBoard.sch]
2016-07-27 Changed board names
    Motherboard is now, and will always be "dartmouth", the nuturing mother
    who brought me into this world
    [dartmouth.kicad_pcb, dartmouth.sch]
2016-07-31 Intitial commit of Cranberry
    [cranberry.kicad_pcb, cranberry.sch]
2016-10-25 Updated to working copy
    [cranberry.kicad_pcb, cranberry.sch, dartmouth.kicad_pcb, dartmouth.sch, loon.kicad_pcb, loon.sch, settle.kicad_pcb, settle.sch]
